herrsergio/diy-concert-led-wearable/docs/schematic.kicad_sch

## KiCad design docs/schematic.kicad_sch (2026-07-30)

Schematic: schematic.kicad_sch

Parts:
BT1: 18650_3000mAh
C1: 1000uF/6.3V; CP_Radial_D10.0mm_P5.00mm
LED1: WS2812B_60LED_1m
R1: 470; R_Axial_DIN0207_L6.3mm_D2.5mm_P10.16mm_Horizontal
SW1: MODE/PATTERN
SW2: BRIGHTNESS
SW3: ON/OFF
U1: ESP32-S3-DevKitC-1
U2: INMP441
U3: TP4056_USB-C
U4: MT3608_5V

Notes on the sheet:
NOTES: 1. R1 (470 ohm) must be placed close to WS2812B DIN pin 2. C1 (1000uF) across LED strip +5V/GND prevents inrush damage 3. INMP441 L/R tied to GND = left channel (matches firmware config) 4. Buttons use ESP32 internal pull-up (INPUT_PULLUP), no external resistors 5. For breadboard testing: po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
POWER SECTION (Phase 4 - Wearable Build) 18650 (3.7V) -> TP4056 (charge/protect) -> MT3608 (boost to 5V) -> SW3 -> System 5V Estimated runtime: ~3.3h at 40% brightness (900mA avg draw)
