herrsergio/diy-concert-led-wearable/(commit log)

2026-08-31 Different fixes for the Wokwi simulator (#1)
    * Doing fixes for the Wokwi simulator
    * Update platformio.ini
    * Update fft_processor.cpp
    * Update config.h
    * Update main.cpp
    * Update mode_manager.cpp
    * Update README.md
    * Update CLAUDE.md
    * Change number of LEDs in strip, comment out library
    [config.h, fft_processor.cpp, fft_processor.h, main.cpp]
2026-09-03 Enhance beat detection (#2)
    * Update audio_capture.cpp
    * Update audio_capture.cpp
    * Add logging messages for mic test
    * Update audio_capture.cpp
    * Update audio_capture.cpp
    * Change BEAT_SENSITIVITY
    * Update beat_detector.cpp
    * Update patterns.h
    * Fix overwritten of incorrect file
    * Update patterns.cpp
    * Update patterns.cpp
    * Changing config values
    * Changing config values
    * Fix false beat detection on ambient noise, retarget to ESP32-WROOM-32
    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
    [audio_capture.cpp, beat_detector.cpp, config.h, fft_processor.cpp, fft_processor.h, main.cpp]
2026-09-04 Feature: enhance beat detection (#3)
    * Add files with output samples
    * Add I2S frame probe: mic is not capturing music, mid/high identical in both sample logs
    * Add I2S frame probe: mic is not capturing music, mid/high identical in both sample logs.
    * Add I2S frame probe: mic is not capturing music, mid/high identical in both sample logs
    * Add I2S frame probe: mic is not capturing music, mid/high identical in both sample logs
    * Add I2S frame probe: mic is not capturing music, mid/high identical in both sample logs
    * Add probe output file
    * Add probe output files
    * Add probe output files
    * Fix false beats: audio read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
    [audio_capture.cpp, beat_detector.cpp, beat_detector.h, config.h, fft_processor.cpp, fft_processor.h, main.cpp]
